antonljunggren/super8_scanner/cad/Scanner_Sketch.FCStd

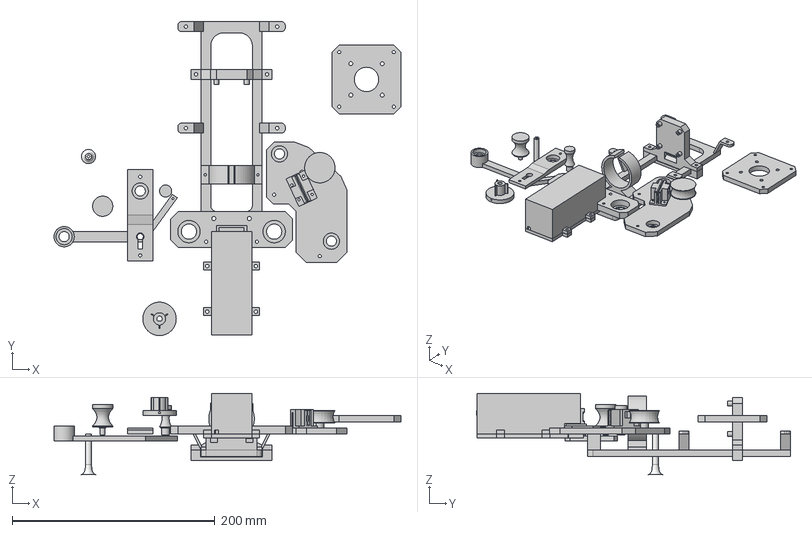
[picture p6: CAD file, 2024-04-15]
cad/Scanner_Sketch.FCStd
342.0 x 309.7 x 80.0 mm
CameraRailMountBackplate
CameraRailMountBottom
CameraLensRailMountBody
