antonljunggren/super8_scanner/(threads)

Thread 1 (2025-01-10):

Which Microscope Lens?

geekman7473, 2025-01-10:
Hi!

I'm interested in reproducing this build. Can you provide more detail on which specific microscope lens you used?

Thanks in advance

antonljunggren, 2025-01-15:
Hi!

Thank you for taking an interest in the project.
I used a "generic" C mount microscope lens, here are some short Amazon links:

https://a.co/d/ctp5DsX
https://a.co/d/d8ANGi0
https://a.co/d/cFxNVnV

But you can just search "c mount microscope lens" and get many options.

I think I have a 100X zoom one. (adjustable)

Then when you assemble the device you can slide the camera back and forth and adjust the zoom on the lens, in the case you cannot get the correct zoom and focus you can modify the sled base to be longer to allow more movement.
But the current one should be enough.

Hope this helps and good luck!
Just reach out if there's anything.
