antonljunggren/super8_scanner/(commit log)

2024-04-15 initial commit, all code, readme and imgs
    [Scanner_Sketch.FCStd]
2024-04-15 added note for stepper driver microstepping
2024-04-20 updated pins from circuit diagram
